andrea-zanetti/comeunlit/hw/shield_rev1/comelit_bus_shield_rev1.kicad_pcb

## KiCad design hw/shield_rev1/comelit_bus_shield_rev1.kicad_pcb (2026-11-10)

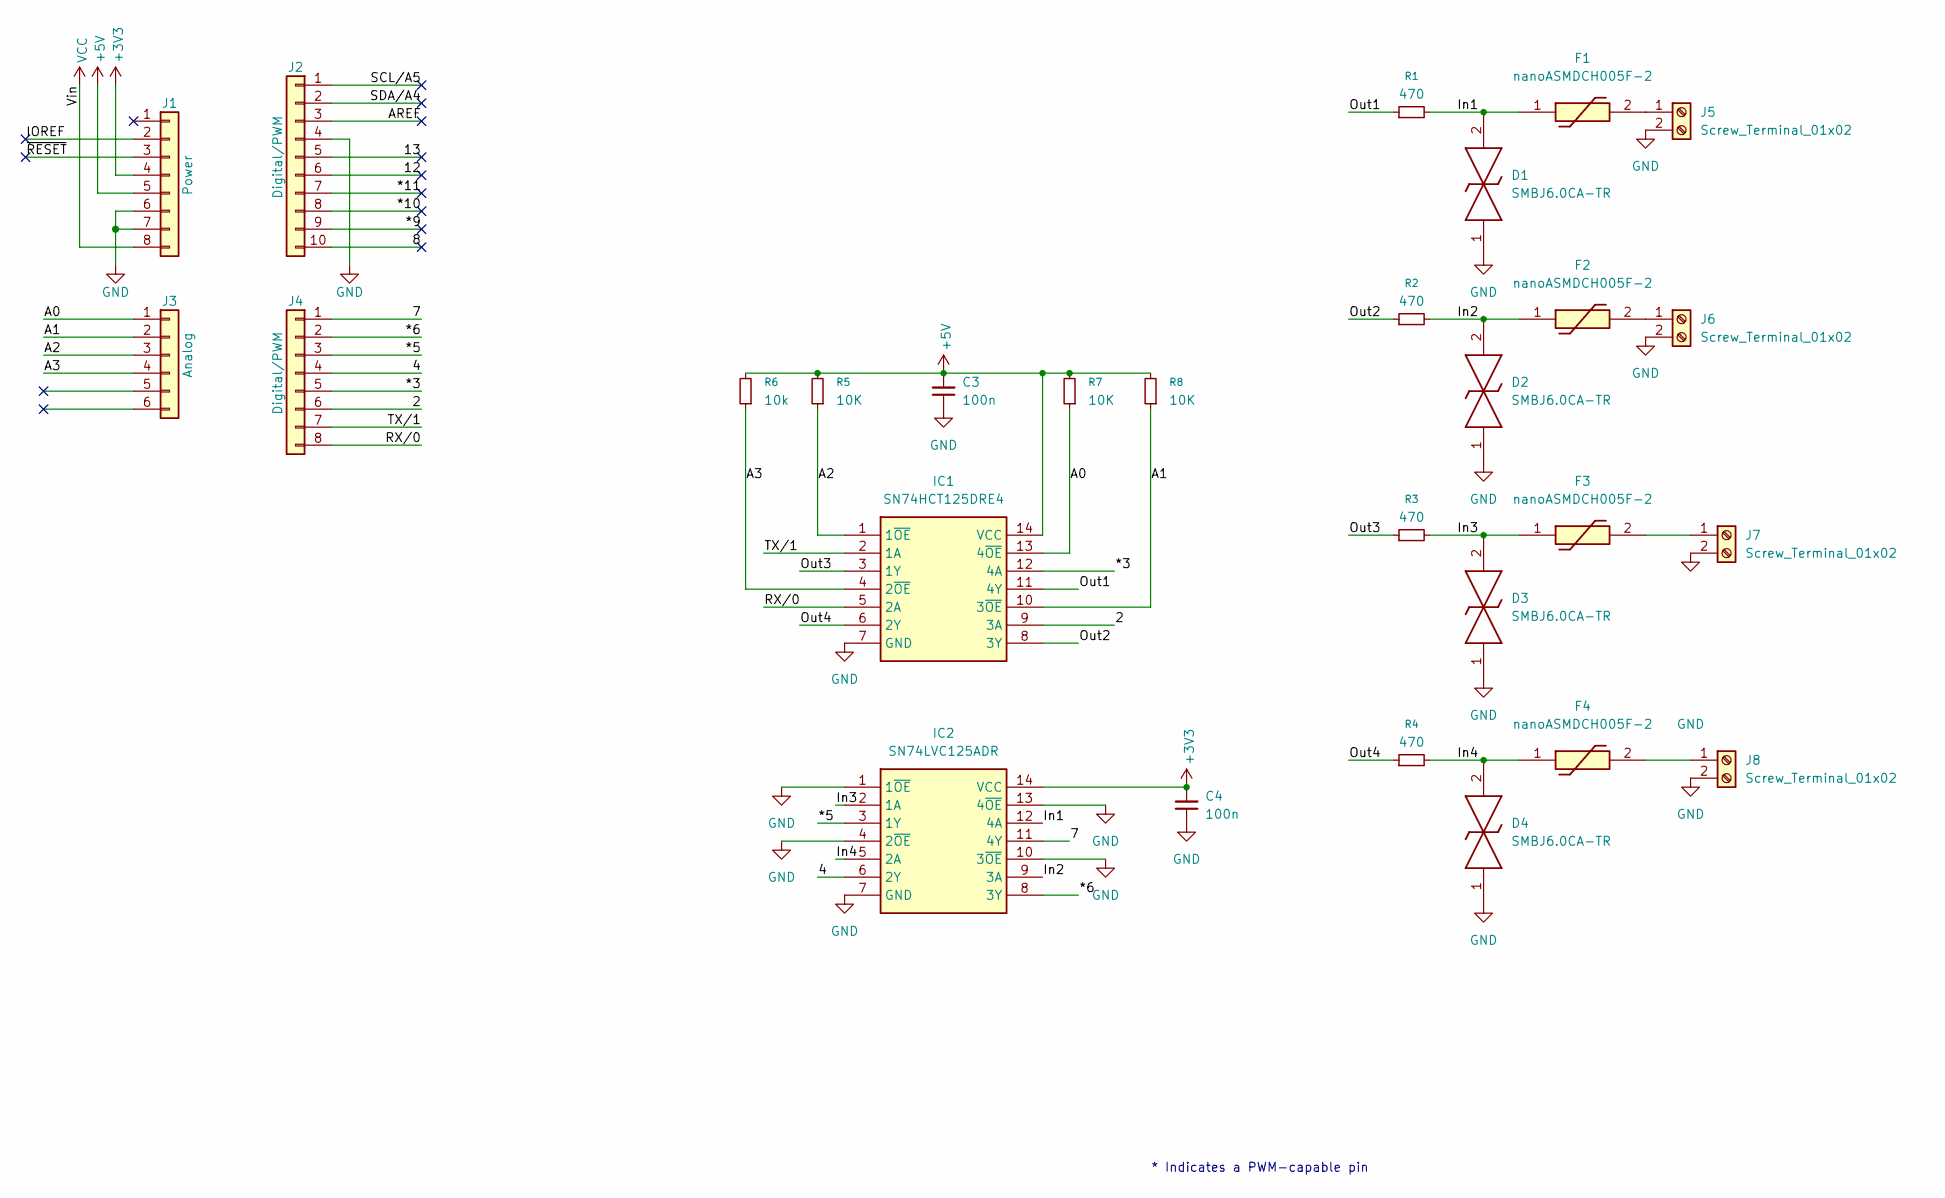
[picture p3: schematic comelit_bus_shield_rev1.kicad_sch]

Parts:
C3, C4: 100n; C_0603_1608Metric_Pad1.08x0.95mm_HandSolder
D1, D2, D3, D4: SMBJ6.0CA-TR; DIONM5436X265N; Mouser Part Number 511-SMBJ6.0CA-TR
F1, F2, F3, F4: nanoASMDCH005F-2; FUSC3216X85N; Mouser Part Number 576-NANOASMDCH005F-2
IC1: SN74HCT125DRE4; SOIC127P600X175-14N; Mouser Part Number 595-SN74HCT125DRE4
IC2: SN74LVC125ADR; SOIC127P600X175-14N; Mouser Part Number 595-SN74LVC125ANSR
J1: Power; PinSocket_1x08_P2.54mm_Vertical
J2: Digital/PWM; PinSocket_1x10_P2.54mm_Vertical
J3: Analog; PinSocket_1x06_P2.54mm_Vertical
J4: Digital/PWM; PinSocket_1x08_P2.54mm_Vertical
J5, J6, J7, J8: Screw_Terminal_01x02; TerminalBlock_Phoenix_MKDS-1-2-3.81_1x02_P3.81mm_Horizontal
R1, R2, R3, R4: 470; R_0603_1608Metric_Pad0.98x0.95mm_HandSolder
R5, R7, R8: 10K; R_0603_1608Metric_Pad0.98x0.95mm_HandSolder
R6: 10k; R_0603_1608Metric_Pad0.98x0.95mm_HandSolder

Connections:
+3V3: C4.2, IC2.14 (VCC), J1.4
+5V: C3.2, IC1.14 (VCC), J1.5, R5.2, R6.2, R7.2, R8.2
/2: IC1.9 (3A), J4.6
/4: IC2.6 (2Y), J4.4
/7: IC2.11 (4Y), J4.1
/8: J2.10
/12: J2.6
/13: J2.5
/*3: IC1.12 (4A), J4.5
/*5: IC2.3 (1Y), J4.3
/*6: IC2.8 (3Y), J4.2
/*9: J2.9
/*10: J2.8
/*11: J2.7
/A0: IC1.13 (4~OE), J3.1, R7.1
/A1: IC1.10 (3~OE), J3.2, R8.1
/A2: IC1.1 (1~OE), J3.3, R5.1
/A3: IC1.4 (2~OE), J3.4, R6.1
/AREF: J2.3
/IOREF: J1.2
/In1: D1.2, F1.1, IC2.12 (4A), R1.2
/In2: D2.2, F2.1, IC2.9 (3A), R2.2
/In3: D3.2, F3.1, IC2.2 (1A), R3.2
/In4: D4.2, F4.1, IC2.5 (2A), R4.2
/Out1: IC1.11 (4Y), R1.1
/Out2: IC1.8 (3Y), R2.1
/Out3: IC1.3 (1Y), R3.1
/Out4: IC1.6 (2Y), R4.1
/RX/0: IC1.5 (2A), J4.8
/SCL/A5: J2.1
/SDA/A4: J2.2
/TX/1: IC1.2 (1A), J4.7
/~RESET: J1.3
GND: C3.1, C4.1, D1.1, D2.1, D3.1, D4.1, IC1.7 (GND), IC2.1 (1~OE), IC2.4 (2~OE), IC2.7 (GND), IC2.10 (3~OE), IC2.13 (4~OE), J1.6, J1.7, J2.4, J5.2, J6.2, J7.2, J8.2
unnamed: F1.2, J5.1
unnamed: F2.2, J6.1
unnamed: F3.2, J7.1
unnamed: F4.2, J8.1
VCC: J1.8

Notes on the sheet:
* Indicates a PWM-capable pin

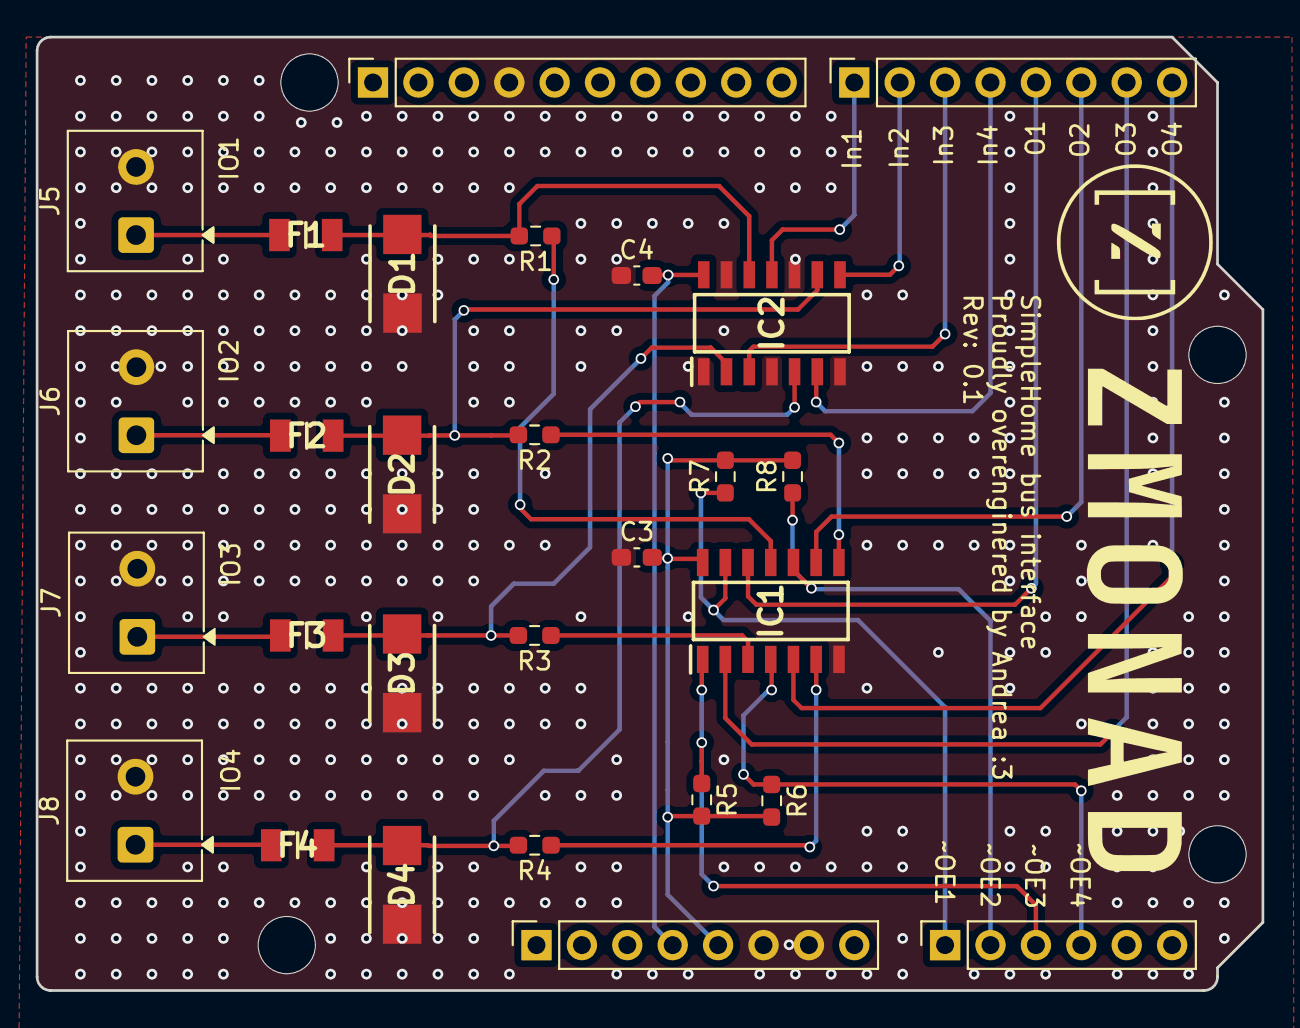
[picture p4: board comelit_bus_shield_rev1.kicad_pcb from above]

Board: 2 copper layers, 68.6 x 53.3 mm, 33 parts (0 on the bottom side), 27 nets.

Other parts of the board:
MH1, MH2, MH3, MH4: MountingHole_3.2mm
logo: LOGO
