andrea-zanetti/comeunlit/Core/Src/main.c

/**
 ******************************************************************************
 * @file           : main.c
 * @brief          : Main program body
 ******************************************************************************
 * @attention
 *
 * Copyright (c) 2026 STMicroelectronics.
 * All rights reserved.
 *
 * This software is licensed under terms that can be found in the LICENSE file
 * in the root directory of this software component.
 * If no LICENSE file comes with this software, it is provided AS-IS.
 *
 ******************************************************************************
 */
/* Includes ------------------------------------------------------------------*/
#include "main.h"

#include "cmsis_os2.h"
#include "string.h"

/* Private includes ----------------------------------------------------------*/
#include <stdio.h>

#include "simplebus_rx.h"

/* Private variables ---------------------------------------------------------*/

ETH_TxPacketConfigTypeDef TxConfig;

COM_InitTypeDef BspCOMInit;

TIM_HandleTypeDef htim1;

/* Private function prototypes -----------------------------------------------*/
void SystemClock_Config(void);
static void MPU_Config(void);
void MX_FREERTOS_Init(void);
static void MX_GPIO_Init(void);
static void MX_ICACHE_Init(void);
static void MX_TIM1_Init(void);
static void MX_FLASH_Init(void);
static void console_init(void);

/**
 * Console (COM1 = USART3 on PD8/PD9, ST-LINK VCP), 115200 8N1.
 *
 * Needs only HAL_Init() and the system clock: the BSP enables the USART
 * clock and configures its own pins. Called first thing after the
 * peripheral inits so that every printf from here on (including the ones
 * in MX_FREERTOS_Init / simplebus_tx_init) reaches the console.
 */
static void console_init(void) {
    BspCOMInit.BaudRate = 115200;
    BspCOMInit.WordLength = COM_WORDLENGTH_8B;
    BspCOMInit.StopBits = COM_STOPBITS_1;
    BspCOMInit.Parity = COM_PARITY_NONE;
    BspCOMInit.HwFlowCtl = COM_HWCONTROL_NONE;
    if (BSP_COM_Init(COM1, &BspCOMInit) != BSP_ERROR_NONE) {
        Error_Handler();
    }
}

/**
 * @brief  The application entry point.
 * @retval int
 */
int main(void) {
    MPU_Config();

    /* Reset of all peripherals, Initializes the Flash interface and the
     * Systick. */
    HAL_Init();

    /* Configure the system clock */
    SystemClock_Config();

    /* Initialize all configured peripherals */
    MX_GPIO_Init();
    MX_ICACHE_Init();
    MX_TIM1_Init();
    MX_FLASH_Init();

    /* 1. Console first, so every later message is visible. */
    console_init();
    printf("\r\n=== SimpleBus Bridge ===\r\n");

    /* 2. Receivers: RX pins -> timer AF, start capture interrupts.
     *    Needs MX_TIM1_Init(). The ISR only touches receiver state (no RTOS
     *    calls), so enabling it before the scheduler is safe. */
    simplebus_rx_init(&htim1);

    /* Init scheduler */
    osKernelInitialize();
    /* Call init function for freertos objects (in app_freertos.c).
     * simplebus_tx_init() runs in here: it must come AFTER MX_GPIO_Init(),
     * which configures PB6/PB7 as LPUART1; TX reclaims them as outputs. */
    MX_FREERTOS_Init();

    /* Initialize leds */
    BSP_LED_Init(LED_YELLOW);
    BSP_LED_Init(LED_RED);

    /* Initialize USER push-button, will be used to trigger an interrupt each
     * time it's pressed.*/
    BSP_PB_Init(BUTTON_USER, BUTTON_MODE_EXTI);

    printf("MAIN: starting kernel\r\n");

    /* Start scheduler */
    osKernelStart();

    /* Only reached if the kernel failed to start. RX processing lives in the
     * receiver task. */
    Error_Handler();
}

/**
 * @brief System Clock Configuration
 * @retval None
 */
void SystemClock_Config(void) {
    RCC_OscInitTypeDef RCC_OscInitStruct = {0};
    RCC_ClkInitTypeDef RCC_ClkInitStruct = {0};

    /** Configure the main internal regulator output voltage
     */
    __HAL_PWR_VOLTAGESCALING_CONFIG(PWR_REGULATOR_VOLTAGE_SCALE0);

    while (!__HAL_PWR_GET_FLAG(PWR_FLAG_VOSRDY)) {
    }

    /** Initializes the RCC Oscillators according to the specified parameters
     * in the RCC_OscInitTypeDef structure.
     */
    RCC_OscInitStruct.OscillatorType = RCC_OSCILLATORTYPE_HSE;
    RCC_OscInitStruct.HSEState = RCC_HSE_BYPASS;
    RCC_OscInitStruct.PLL.PLLState = RCC_PLL_ON;
    RCC_OscInitStruct.PLL.PLLSource = RCC_PLL1_SOURCE_HSE;
    RCC_OscInitStruct.PLL.PLLM = 4;
    RCC_OscInitStruct.PLL.PLLN = 250;
    RCC_OscInitStruct.PLL.PLLP = 2;
    RCC_OscInitStruct.PLL.PLLQ = 2;
    RCC_OscInitStruct.PLL.PLLR = 2;
    RCC_OscInitStruct.PLL.PLLRGE = RCC_PLL1_VCIRANGE_1;
    RCC_OscInitStruct.PLL.PLLVCOSEL = RCC_PLL1_VCORANGE_WIDE;
    RCC_OscInitStruct.PLL.PLLFRACN = 0;
    if (HAL_RCC_OscConfig(&RCC_OscInitStruct) != HAL_OK) {
        Error_Handler();
    }

    /** Initializes the CPU, AHB and APB buses clocks
     */
    RCC_ClkInitStruct.ClockType = RCC_CLOCKTYPE_HCLK | RCC_CLOCKTYPE_SYSCLK |
                                  RCC_CLOCKTYPE_PCLK1 | RCC_CLOCKTYPE_PCLK2 |
                                  RCC_CLOCKTYPE_PCLK3;
    RCC_ClkInitStruct.SYSCLKSource = RCC_SYSCLKSOURCE_PLLCLK;
    RCC_ClkInitStruct.AHBCLKDivider = RCC_SYSCLK_DIV1;
    RCC_ClkInitStruct.APB1CLKDivider = RCC_HCLK_DIV1;
    RCC_ClkInitStruct.APB2CLKDivider = RCC_HCLK_DIV1;
    RCC_ClkInitStruct.APB3CLKDivider = RCC_HCLK_DIV1;

    if (HAL_RCC_ClockConfig(&RCC_ClkInitStruct, FLASH_LATENCY_5) != HAL_OK) {
        Error_Handler();
    }

    /** Configure the programming delay
     */
    __HAL_FLASH_SET_PROGRAM_DELAY(FLASH_PROGRAMMING_DELAY_2);
}

/**
 * @brief FLASH Initialization Function
 * @param None
 * @retval None
 */
static void MX_FLASH_Init(void) {
    if (HAL_FLASH_Unlock() != HAL_OK) {
        Error_Handler();
    }
    if (HAL_FLASH_Lock() != HAL_OK) {
        Error_Handler();
    }
}

/**
 * @brief ICACHE Initialization Function
 * @param None
 * @retval None
 */
static void MX_ICACHE_Init(void) {
    /** Enable instruction cache in 1-way (direct mapped cache)
     */
    if (HAL_ICACHE_ConfigAssociativityMode(ICACHE_1WAY) != HAL_OK) {
        Error_Handler();
    }
    if (HAL_ICACHE_Enable() != HAL_OK) {
        Error_Handler();
    }
}

/**
 * @brief TIM1 Initialization Function
 * @param None
 * @retval None
 */
static void MX_TIM1_Init(void) {
    TIM_ClockConfigTypeDef sClockSourceConfig = {0};
    TIM_MasterConfigTypeDef sMasterConfig = {0};
    TIM_IC_InitTypeDef sConfigIC = {0};

    htim1.Instance = TIM1;
    htim1.Init.Prescaler = 249;
    htim1.Init.CounterMode = TIM_COUNTERMODE_UP;
    htim1.Init.Period = 65535;
    htim1.Init.ClockDivision = TIM_CLOCKDIVISION_DIV1;
    htim1.Init.RepetitionCounter = 0;
    htim1.Init.AutoReloadPreload = TIM_AUTORELOAD_PRELOAD_DISABLE;
    if (HAL_TIM_Base_Init(&htim1) != HAL_OK) {
        Error_Handler();
    }
    sClockSourceConfig.ClockSource = TIM_CLOCKSOURCE_INTERNAL;
    if (HAL_TIM_ConfigClockSource(&htim1, &sClockSourceConfig) != HAL_OK) {
        Error_Handler();
    }
    if (HAL_TIM_IC_Init(&htim1) != HAL_OK) {
        Error_Handler();
    }
    sMasterConfig.MasterOutputTrigger = TIM_TRGO_RESET;
    sMasterConfig.MasterOutputTrigger2 = TIM_TRGO2_RESET;
    sMasterConfig.MasterSlaveMode = TIM_MASTERSLAVEMODE_DISABLE;
    if (HAL_TIMEx_MasterConfigSynchronization(&htim1, &sMasterConfig) !=
        HAL_OK) {
        Error_Handler();
    }
    /* All four channels are configured so any shield revision works;
     * simplebus_rx_init() only routes pins to and starts the channels the
     * shield map actually uses (rev 1: CH1, CH2, CH4). */
    sConfigIC.ICPolarity = TIM_INPUTCHANNELPOLARITY_FALLING;
    sConfigIC.ICSelection = TIM_ICSELECTION_DIRECTTI;
    sConfigIC.ICPrescaler = TIM_ICPSC_DIV1;
    sConfigIC.ICFilter = 0;
    if (HAL_TIM_IC_ConfigChannel(&htim1, &sConfigIC, TIM_CHANNEL_1) != HAL_OK) {
        Error_Handler();
    }
    if (HAL_TIM_IC_ConfigChannel(&htim1, &sConfigIC, TIM_CHANNEL_2) != HAL_OK) {
        Error_Handler();
    }
    if (HAL_TIM_IC_ConfigChannel(&htim1, &sConfigIC, TIM_CHANNEL_3) != HAL_OK) {
        Error_Handler();
    }
    if (HAL_TIM_IC_ConfigChannel(&htim1, &sConfigIC, TIM_CHANNEL_4) != HAL_OK) {
        Error_Handler();
    }
}

/**
 * @brief GPIO Initialization Function
 * @param None
 * @retval None
 */
static void MX_GPIO_Init(void) {
    GPIO_InitTypeDef GPIO_InitStruct = {0};

    /* GPIO Ports Clock Enable */
    __HAL_RCC_GPIOE_CLK_ENABLE();
    __HAL_RCC_GPIOC_CLK_ENABLE();
    __HAL_RCC_GPIOH_CLK_ENABLE();
    __HAL_RCC_GPIOA_CLK_ENABLE();
    __HAL_RCC_GPIOB_CLK_ENABLE();
    __HAL_RCC_GPIOD_CLK_ENABLE();
    __HAL_RCC_GPIOG_CLK_ENABLE();

    /*Configure GPIO pin : VBUS_SENSE_Pin */
    GPIO_InitStruct.Pin = VBUS_SENSE_Pin;
    GPIO_InitStruct.Mode = GPIO_MODE_ANALOG;
    GPIO_InitStruct.Pull = GPIO_NOPULL;
    HAL_GPIO_Init(VBUS_SENSE_GPIO_Port, &GPIO_InitStruct);

    /*Configure GPIO pins : UCPD_CC1_Pin UCPD_CC2_Pin */
    GPIO_InitStruct.Pin = UCPD_CC1_Pin | UCPD_CC2_Pin;
    GPIO_InitStruct.Mode = GPIO_MODE_ANALOG;
    GPIO_InitStruct.Pull = GPIO_NOPULL;
    HAL_GPIO_Init(GPIOB, &GPIO_InitStruct);

    /*Configure GPIO pins : PD8 PD9 */
    GPIO_InitStruct.Pin = GPIO_PIN_8 | GPIO_PIN_9;
    GPIO_InitStruct.Mode = GPIO_MODE_AF_PP;
    GPIO_InitStruct.Pull = GPIO_NOPULL;
    GPIO_InitStruct.Speed = GPIO_SPEED_FREQ_LOW;
    GPIO_InitStruct.Alternate = GPIO_AF7_USART3;
    HAL_GPIO_Init(GPIOD, &GPIO_InitStruct);

    /*Configure GPIO pin : UCPD_FLT_Pin */
    GPIO_InitStruct.Pin = UCPD_FLT_Pin;
    GPIO_InitStruct.Mode = GPIO_MODE_IT_RISING;
    GPIO_InitStruct.Pull = GPIO_NOPULL;
    HAL_GPIO_Init(UCPD_FLT_GPIO_Port, &GPIO_InitStruct);

    /*Configure GPIO pins : USB_FS_N_Pin USB_FS_P_Pin */
    GPIO_InitStruct.Pin = USB_FS_N_Pin | USB_FS_P_Pin;
    GPIO_InitStruct.Mode = GPIO_MODE_AF_PP;
    GPIO_InitStruct.Pull = GPIO_NOPULL;
    GPIO_InitStruct.Speed = GPIO_SPEED_FREQ_LOW;
    GPIO_InitStruct.Alternate = GPIO_AF10_USB;
    HAL_GPIO_Init(GPIOA, &GPIO_InitStruct);

    /*Configure GPIO pins : ARD_D1_TX_Pin ARD_D0_RX_Pin */
    /* NOTE: PB6/PB7 are SimpleBus TX data lines on the shield; this LPUART1
     * setup is overridden by simplebus_tx_init() later in boot. */
    GPIO_InitStruct.Pin = ARD_D1_TX_Pin | ARD_D0_RX_Pin;
    GPIO_InitStruct.Mode = GPIO_MODE_AF_PP;
    GPIO_InitStruct.Pull = GPIO_NOPULL;
    GPIO_InitStruct.Speed = GPIO_SPEED_FREQ_LOW;
    GPIO_InitStruct.Alternate = GPIO_AF8_LPUART1;
    HAL_GPIO_Init(GPIOB, &GPIO_InitStruct);
}

/* MPU Configuration */

void MPU_Config(void) {
    MPU_Region_InitTypeDef MPU_InitStruct = {0};
    MPU_Attributes_InitTypeDef MPU_AttributesInit = {0};

    /* Disables the MPU */
    HAL_MPU_Disable();

    /** Initializes and configures the Region 0 and the memory to be protected
     */
    MPU_InitStruct.Enable = MPU_REGION_ENABLE;
    MPU_InitStruct.Number = MPU_REGION_NUMBER0;
    MPU_InitStruct.BaseAddress = 0x08FFF000;
    MPU_InitStruct.LimitAddress = 0x08FFFFFF;
    MPU_InitStruct.AttributesIndex = MPU_ATTRIBUTES_NUMBER0;
    MPU_InitStruct.AccessPermission = MPU_REGION_ALL_RO;
    MPU_InitStruct.DisableExec = MPU_INSTRUCTION_ACCESS_DISABLE;
    MPU_InitStruct.IsShareable = MPU_ACCESS_NOT_SHAREABLE;

    HAL_MPU_ConfigRegion(&MPU_InitStruct);

    /** Initializes and configures the Attribute 0 and the memory to be
     * protected
     */
    MPU_AttributesInit.Number = MPU_ATTRIBUTES_NUMBER0;
    MPU_AttributesInit.Attributes = INNER_OUTER(MPU_NOT_CACHEABLE);

    HAL_MPU_ConfigMemoryAttributes(&MPU_AttributesInit);
    /* Enables the MPU */
    HAL_MPU_Enable(MPU_PRIVILEGED_DEFAULT);
}

/**
 * @brief  This function is executed in case of error occurrence.
 * @retval None
 */
void Error_Handler(void) {
    /* Fatal: stop here with interrupts off. A debugger's call stack shows
     * which init step failed. */
    __disable_irq();
    while (1) {
    }
}
#ifdef USE_FULL_ASSERT
/**
 * @brief  Reports the name of the source file and the source line number
 *         where the assert_param error has occurred.
 * @param  file: pointer to the source file name
 * @param  line: assert_param error line source number
 * @retval None
 */
void assert_failed(uint8_t* file, uint32_t line) {
    (void)file;
    (void)line;
}
#endif /* USE_FULL_ASSERT */
